TalhaTelli427/DAND_IQ/firmware/stm32g031/Core/Inc/main.h

#define CS_SIGNAL_Pin GPIO_PIN_4
#define CS_SIGNAL_GPIO_Port GPIOA
#define SX_RESET_Pin GPIO_PIN_11
#define SX_RESET_GPIO_Port GPIOA
#define LED1_Pin GPIO_PIN_12
#define LED1_GPIO_Port GPIOA
