TalhaTelli427/DAND_IQ/fpga/rtl/common/not_rst.vhd

----------------------------------------------------------------------------------
-- Company: 
-- Engineer: 
-- 
-- Create Date: 18.08.2026 17:16:48
-- Design Name: 
-- Module Name: not_rst - Behavioral
-- Project Name: 
-- Target Devices: 
-- Tool Versions: 
-- Description: 
-- 
-- Dependencies: 
-- 
-- Revision:
-- Revision 0.01 - File Created
-- Additional Comments:
-- 
----------------------------------------------------------------------------------


library IEEE;
use IEEE.STD_LOGIC_1164.ALL;

-- Uncomment the following library declaration if using
-- arithmetic functions with Signed or Unsigned values
--use IEEE.NUMERIC_STD.ALL;

-- Uncomment the following library declaration if instantiating
-- any Xilinx leaf cells in this code.
--library UNISIM;
--use UNISIM.VComponents.all;

entity not_rst is
    Port ( D_in : in STD_LOGIC;
           D_out : out STD_LOGIC);
end not_rst;

architecture Behavioral of not_rst is

begin
   D_out <= not D_in;

end Behavioral;
