TalhaTelli427/DAND_IQ/(notices)

Notices in the files:
firmware/stm32g031/Core/Inc/main.h:
Copyright (c) 2026 STMicroelectronics.
All rights reserved.
This software is licensed under terms that can be found in the LICENSE file
README.md:
License: MIT
